CollettivoCocomeri/Felfil-Evo/README.md

# Felfil Evo
Evolved open source DIY 3D printer filament extruder

In this folder you will find all you need to replicate, modify and implement Felfil Evo

Contents of the folder:

- 3D-Model
- BOM
- Electronics
- FEBK - Basic Kit
- License

Last update: 18/07/2016
