CollettivoCocomeri/Felfil-Evo/Electronics/PCB - WIP/readme

This is the WIP of the brand new PCB of Felfil Evo.

It's not ready, now is going to be tested.

---
PCB Release Date: 09/06/2016
PCB Version: 0.9
---
