CollettivoCocomeri/Felfil-Evo/BOM/readme

In this folder you will find:

- Basic BOM (Bill of Materials) of Felfil Evo.

---
BOM Released Date: 17/11/2015
BOM Version: 1.0
---
