CollettivoCocomeri/Felfil-Evo/3D-Model/PrintableModel/HopperTop.stl

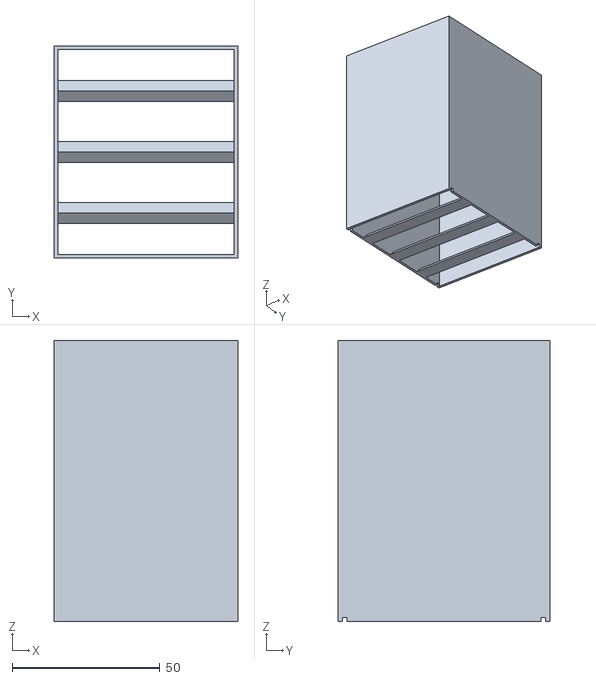
[picture p1: CAD file, 2017-03-28]
3D-Model/PrintableModel/HopperTop.stl
62.3 x 72.0 x 95.2
