CollettivoCocomeri/Felfil-Evo/3D-Model/PrintableModel/HopperBottom.stl

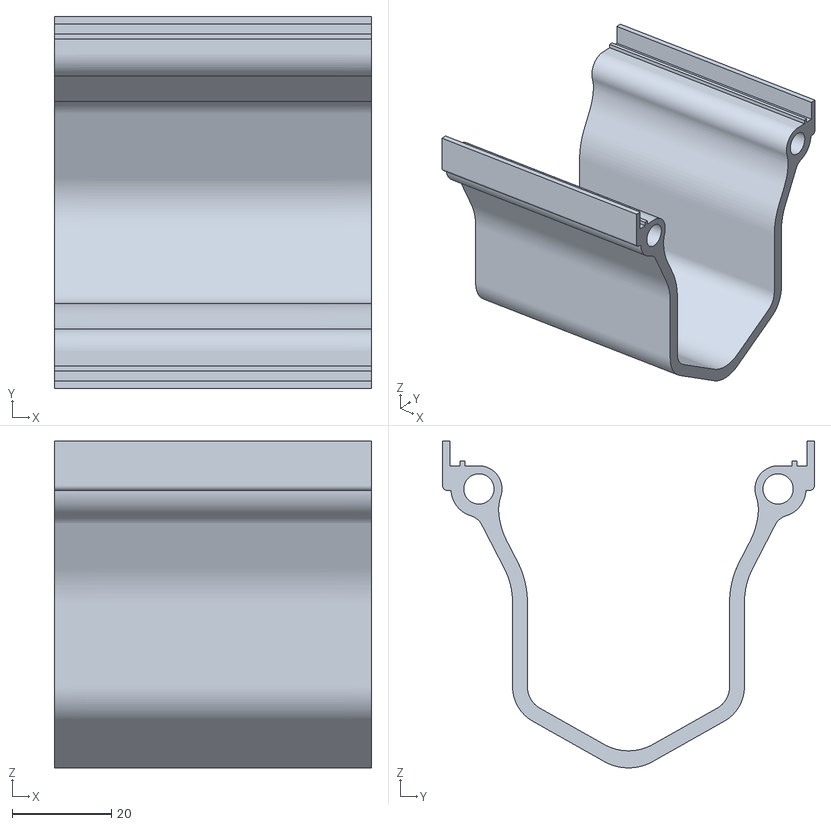
[picture p2: CAD file, 2017-03-28]
3D-Model/PrintableModel/HopperBottom.stl
64.0 x 75.1 x 65.9
