CollettivoCocomeri/Felfil-Evo/3D-Model/PrintableModel/readme

In this folder you can find:

- Top Hopper
- Bottom Hopper

of Felfil Evo.

The files are in .stl format, so you can easily import them in your favorite 3d Printer software.

We encourage you to download, test and enanche them!
