CollettivoCocomeri/Felfil-Evo/(threads)

Thread 4 (2019-01-06):

Thermistor variability

yeowjoon99, 2019-01-06:
My issue with the current felfil evo is to do with it's firmware.

Most people who are interested in the felfil evo are likely interested in 3D printing or own a 3D printer.

The issue I see is that in the firmware, I can't find any kind of temperature table that relates the thermistor's voltages with temperature values like in marlin firmware.
If this arduino board itself is capable of doing this conversion by itself or it's not blatantly shown in the firmware, someone please explain it to me.

Also, in the BOM, almost all parts aren't labelled with the exact type and model being used e.g. Arduino, fan, motor, LCD, encoder, thermistor.

The biggest issue with this lack of information is that I can't find a replacement in the event that that particular component might be damaged. Example would be a faulty thermistor. I wouldn't know which type to get if I don't know what type is used.

However if a temperature table is included in the firmware, it allows users to not only easily replace a faulty thermistor with one with a known temperature table, but it also allows users to upgrade it to a better one if they wish.

CollettivoCocomeri, 2019-01-07:
Hi,
thanks for contacting us, the reason of lacks of a temperature table is that
Felfil Evo does not use a thermistor but a K-type thermocouple.
About the Arduino, we mean a Uno board. The LCD is a i2C, and since it can
change often without advice form the seller, we include in code all the
working address we found. The click encoder module is quite standard.
However we will update the BOM, thaks.

Felfil s.r.l. | P.I. 11482100010
 <http://www.felfil.com/> www.felfil.com | C.so Castelfidardo 30/A, 10129
(TO)

Da: yeowjoon99 <notifications@github.com>
Inviato: domenica 6 gennaio 2019 16:50
A: CollettivoCocomeri/Felfil-Evo <Felfil-Evo@noreply.github.com>
Cc: Subscribed <subscribed@noreply.github.com>
Oggetto: [CollettivoCocomeri/Felfil-Evo] Thermistor variability (#4)

My issue with the current felfil evo is to do with it's firmware.

Most people who are interested in the felfil evo are likely interested in 3D
printing or own a 3D printer.

The issue I see is that in the firmware, I can't find any kind of
temperature table that relates the thermistor's voltages with temperature
values like in marlin firmware.
If this arduino board itself is capable of doing this conversion by itself
or it's not blatantly shown in the firmware, someone please explain it to
me.

Also, in the BOM, almost all parts aren't labelled with the exact type and
model being used e.g. Arduino, fan, motor, LCD, encoder, thermistor.

The biggest issue with this lack of information is that I can't find a
replacement in the event that that particular component might be damaged.
Example would be a faulty thermistor. I wouldn't know which type to get if I
don't know what type is used.

However if a temperature table is included in the firmware, it allows users
to not only easily replace a faulty thermistor with one with a known
temperature table, but it also allows users to upgrade it to a better one if
they wish.

-
You are receiving this because you are subscribed to this thread.
Reply to this email directly, view it on GitHub
<https://github.com/CollettivoCocomeri/Felfil-Evo/issues/4> , or mute the
thread
<https://github.com/notifications/unsubscribe-auth/AOizHdfkJLXkQ0gE0kgNOc7fZ
zvYrdnPks5vAhsUgaJpZM4Zyezb> .
<https://github.com/notifications/beacon/AOizHRxWdJRFGthNxYSVIswKCbr5SNI6ks5
vAhsUgaJpZM4Zyezb.gif>

<https://t.sidekickopen72.com/s1t/o/5/f18dQhb0S7kC8dDMPbW2n0x6l2B9gXrN7sKj6v
5KRN6W56jV1-1q0QkHW4WDX_q7qDc_gf197v5Y04?si=7000000001141521&pi=1855c4bb-ba5
e-42a2-a150-60d48d6bd497>

Closed 2021-09-22.

Thread 5 (2020-03-09):

BOM

Dario-Ciceri, 2020-03-09:
Ciao, a me piacerebbe ricreare questa macchina e magari aggiungere delle modifiche e fare un custom firmware. Non so però quali sono le componenti che usate per creare la macchina. Avreste dei nomi e delle part number? grazie

CollettivoCocomeri, 2020-03-09:
Ciao Dario,
puoi dirmi di quali parti avresti bisogno? Quasi tutta la meccanica è composta da componenti custom realizzati ad hoc di cui puoi trovare i file .step invece per quanto riguarda l’elettronica puoi clonare FelfilIno o realizzarla tramite Arduino e degli opportuni moduli

A presto
Alessandro

Felfil s.r.l. | P.I. 11482100010
 <http://www.felfil.com/> www.felfil.com | C.so Castelfidardo 30/A, 10129 (TO)

Da: Dario-Ciceri <notifications@github.com>
Inviato: lunedì 9 marzo 2020 13:57
A: CollettivoCocomeri/Felfil-Evo <Felfil-Evo@noreply.github.com>
Cc: Subscribed <subscribed@noreply.github.com>
Oggetto: [CollettivoCocomeri/Felfil-Evo] BOM (#5)

Ciao, a me piacerebbe ricreare questa macchina e magari aggiungere delle modifiche e fare un custom firmware. Non so però quali sono le componenti che usate per creare la macchina. Avreste dei nomi e delle part number? grazie

—
You are receiving this because you are subscribed to this thread.
Reply to this email directly, view it on GitHub <https://github.com/CollettivoCocomeri/Felfil-Evo/issues/5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> , or unsubscribe <https://github.com/notifications/unsubscribe-auth/ADULGHMFW6P7XEIHCI3LMVDRGTRSDANCNFSM4LEIDS2Q> .

Dario-Ciceri, 2020-03-09:
> Ciao Dario, puoi dirmi di quali parti avresti bisogno? Quasi tutta la meccanica è composta da componenti custom realizzati ad hoc di cui puoi trovare i file .step invece per quanto riguarda l’elettronica puoi clonare FelfilIno o realizzarla tramite Arduino e degli opportuni moduli A presto Alessandro Felfil s.r.l. | P.I. 11482100010 <http://www.felfil.com/> [www.felfil.com](http://www.felfil.com) | C.so Castelfidardo 30/A, 10129 (TO) Da: Dario-Ciceri <notifications@github.com> Inviato: lunedì 9 marzo 2020 13:57 A: CollettivoCocomeri/Felfil-Evo <Felfil-Evo@noreply.github.com> Cc: Subscribed <subscribed@noreply.github.com> Oggetto: [CollettivoCocomeri/Felfil-Evo] BOM (#5) Ciao, a me piacerebbe ricreare questa macchina e magari aggiungere delle modifiche e fare un custom firmware. Non so però quali sono le componenti che usate per creare la macchina. Avreste dei nomi e delle part number? grazie — You are receiving this because you are subscribed to this thread. Reply to this email directly, view it on GitHub <#5?email_source=notifications&email_token=ADULGHPCW732ITJDAR35GK3RGTRSDA5CNFSM4LEIDS22YY3PNVWWK3TUL52HS4DFUVEXG43VMWVGG33NNVSW45C7NFSM4ITR5NOQ> , or unsubscribe <https://github.com/notifications/unsubscribe-auth/ADULGHMFW6P7XEIHCI3LMVDRGTRSDANCNFSM4LEIDS2Q> .

Ciao, avrei bisogno di sapere il tipo di motore e gearboxes usate. Di file step ne vedo uno solo, è in scala 1:1?
grazie del supporto!

CollettivoCocomeri, 2020-03-09:
Sì il file step è in scala 1:1.
Ti allego qui la scheda tecnica del motore che utilizziamo noi.

Fammi sapere se hai bisogno d’altro.
Ciao
Alessandro

Felfil s.r.l. | P.I. 11482100010
 <http://www.felfil.com/> www.felfil.com | C.so Castelfidardo 30/A, 10129 (TO)

Da: Dario-Ciceri <notifications@github.com>
Inviato: lunedì 9 marzo 2020 16:13
A: CollettivoCocomeri/Felfil-Evo <Felfil-Evo@noreply.github.com>
Cc: Felfil <staff@felfil.com>; Comment <comment@noreply.github.com>
Oggetto: Re: [CollettivoCocomeri/Felfil-Evo] BOM (#5)

Ciao Dario, puoi dirmi di quali parti avresti bisogno? Quasi tutta la meccanica è composta da componenti custom realizzati ad hoc di cui puoi trovare i file .step invece per quanto riguarda l’elettronica puoi clonare FelfilIno o realizzarla tramite Arduino e degli opportuni moduli A presto Alessandro Felfil s.r.l. | P.I. 11482100010 http://www.felfil.com/ www.felfil.com <http://www.felfil.com>  | C.so Castelfidardo 30/A, 10129 (TO) Da: Dario-Ciceri notifications@github.com <mailto:notifications@github.com>  Inviato: lunedì 9 marzo 2020 13:57 A: CollettivoCocomeri/Felfil-Evo Felfil-Evo@noreply.github.com <mailto:Felfil-Evo@noreply.github.com>  Cc: Subscribed subscribed@noreply.github.com <mailto:subscribed@noreply.github.com>  Oggetto: [CollettivoCocomeri/Felfil-Evo] BOM (#5 <https://github.com/CollettivoCocomeri/Felfil-Evo/issues/5> ) Ciao, a me piacerebbe ricreare questa macchina e magari aggiungere delle modifiche e fare un custom firmware. Non so però quali sono le componenti che usate per creare la macchina. Avreste dei nomi e delle part number? grazie — You are receiving this because you are subscribed to this thread. Reply to this email directly, view it on GitHub < <https://github.com/CollettivoCocomeri/Felfil-Evo/issues/5> #5?email_source=notifications&email_token=ADULGHPCW732ITJDAR35GK3RGTRSDA5CNFSM4LEIDS22YY3PNVWWK3TUL52HS4DFUVEXG43VMWVGG33NNVSW45C7NFSM4ITR5NOQ> , or unsubscribe  <https://github.com/notifications/unsubscribe-auth/ADULGHMFW6P7XEIHCI3LMVDRGTRSDANCNFSM4LEIDS2Q> https://github.com/notifications/unsubscribe-auth/ADULGHMFW6P7XEIHCI3LMVDRGTRSDANCNFSM4LEIDS2Q .

Ciao, avrei bisogno di sapere il tipo di motore e gearboxes usate. Di file step ne vedo uno solo, è in scala 1:1?
grazie del supporto!

—
You are receiving this because you commented.
Reply to this email directly,  <https://github.com/CollettivoCocomeri/Felfil-Evo/issues/5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> view it on GitHub, or  <https://github.com/notifications/unsubscribe-auth/ADULGHIP5FZMZ6XAZEJ7XS3RGUBQXANCNFSM4LEIDS2Q> unsubscribe.

Dario-Ciceri, 2020-03-09:
> Sì il file step è in scala 1:1. Ti allego qui la scheda tecnica del motore che utilizziamo noi. Fammi sapere se hai bisogno d’altro. Ciao Alessandro Felfil s.r.l. | P.I. 11482100010 <http://www.felfil.com/> [www.felfil.com](http://www.felfil.com) | C.so Castelfidardo 30/A, 10129 (TO) Da: Dario-Ciceri <notifications@github.com> Inviato: lunedì 9 marzo 2020 16:13 A: CollettivoCocomeri/Felfil-Evo <Felfil-Evo@noreply.github.com> Cc: Felfil <staff@felfil.com>; Comment <comment@noreply.github.com> Oggetto: Re: [CollettivoCocomeri/Felfil-Evo] BOM (#5) Ciao Dario, puoi dirmi di quali parti avresti bisogno? Quasi tutta la meccanica è composta da componenti custom realizzati ad hoc di cui puoi trovare i file .step invece per quanto riguarda l’elettronica puoi clonare FelfilIno o realizzarla tramite Arduino e degli opportuni moduli A presto Alessandro Felfil s.r.l. | P.I. 11482100010 http://www.felfil.com/ [www.felfil.com](http://www.felfil.com) <http://www.felfil.com> | C.so Castelfidardo 30/A, 10129 (TO) Da: Dario-Ciceri notifications@github.com <mailto:notifications@github.com> Inviato: lunedì 9 marzo 2020 13:57 A: CollettivoCocomeri/Felfil-Evo Felfil-Evo@noreply.github.com <mailto:Felfil-Evo@noreply.github.com> Cc: Subscribed subscribed@noreply.github.com <mailto:subscribed@noreply.github.com> Oggetto: [CollettivoCocomeri/Felfil-Evo] BOM (#5 <#5> ) Ciao, a me piacerebbe ricreare questa macchina e magari aggiungere delle modifiche e fare un custom firmware. Non so però quali sono le componenti che usate per creare la macchina. Avreste dei nomi e delle part number? grazie — You are receiving this because you are subscribed to this thread. Reply to this email directly, view it on GitHub < <#5> #5?email_source=notifications&email_token=ADULGHPCW732ITJDAR35GK3RGTRSDA5CNFSM4LEIDS22YY3PNVWWK3TUL52HS4DFUVEXG43VMWVGG33NNVSW45C7NFSM4ITR5NOQ> , or unsubscribe <https://github.com/notifications/unsubscribe-auth/ADULGHMFW6P7XEIHCI3LMVDRGTRSDANCNFSM4LEIDS2Q> https://github.com/notifications/unsubscribe-auth/ADULGHMFW6P7XEIHCI3LMVDRGTRSDANCNFSM4LEIDS2Q . Ciao, avrei bisogno di sapere il tipo di motore e gearboxes usate. Di file step ne vedo uno solo, è in scala 1:1? grazie del supporto! — You are receiving this because you commented. Reply to this email directly, <#5?email_source=notifications&email_token=ADULGHISU66O57UDUAOUSJTRGUBQXA5CNFSM4LEIDS22YY3PNVWWK3TUL52HS4DFVREXG43VMVBW63LNMVXHJKTDN5WW2ZLOORPWSZGOEOHUHBI#issuecomment-596591493> view it on GitHub, or <https://github.com/notifications/unsubscribe-auth/ADULGHIP5FZMZ6XAZEJ7XS3RGUBQXANCNFSM4LEIDS2Q> unsubscribe.

ok grazie, aspetto che carichi la scheda tecnica! Se farò qualche modifica alla macchina la pubblicherò su una branch di questo progetto. A presto!!

CollettivoCocomeri, 2020-03-09:
Caricato!

Closed 2020-05-25.
