CollettivoCocomeri/Felfil-Evo/BOM/E1. Mellormotor.pdf

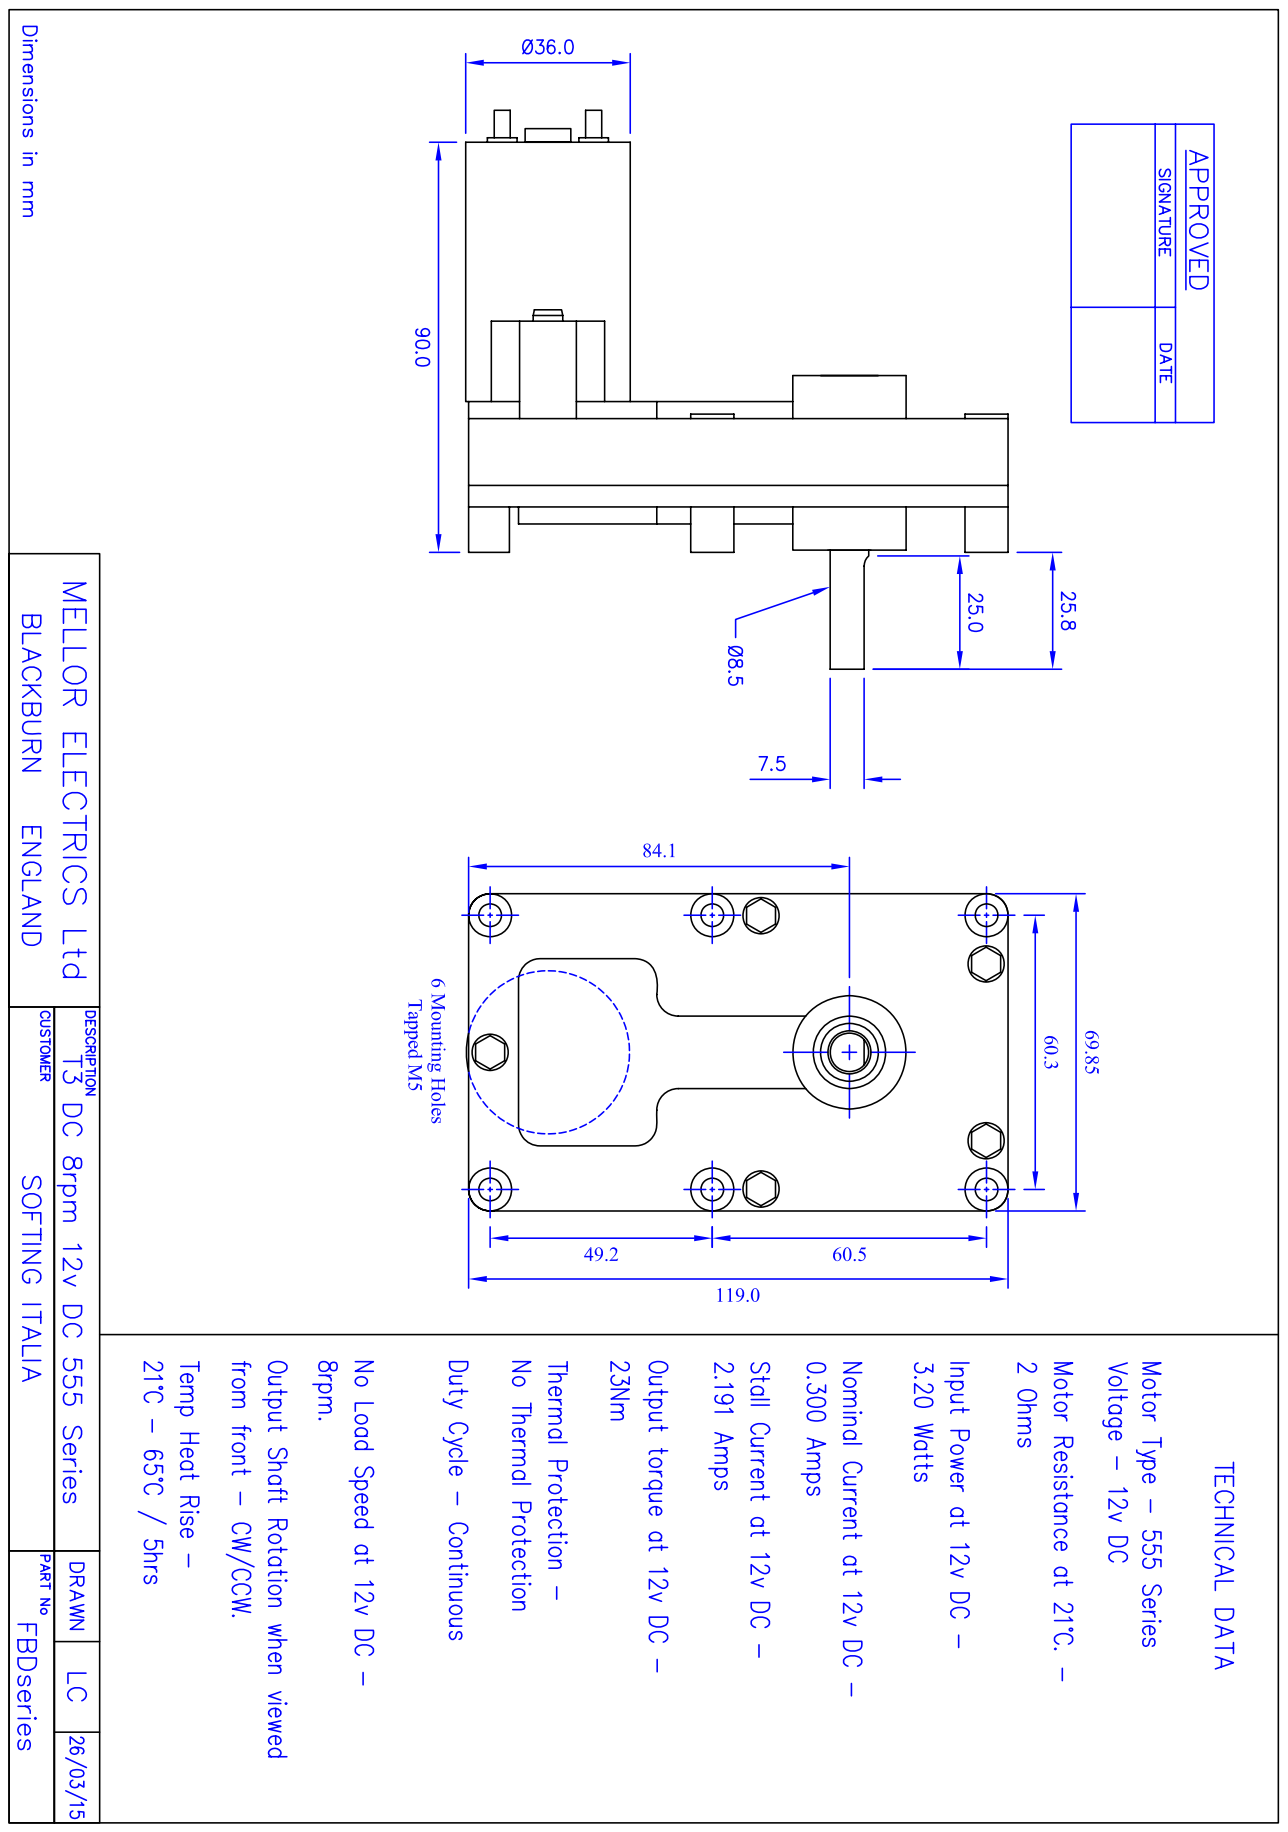
[picture p3: page 1]
