CollettivoCocomeri/Felfil-Evo/Electronics/PCB - WIP/Felfil_PCB_0.9.brd

## EAGLE design Electronics/PCB - WIP/Felfil_PCB_0.9.brd (2016-06-09)

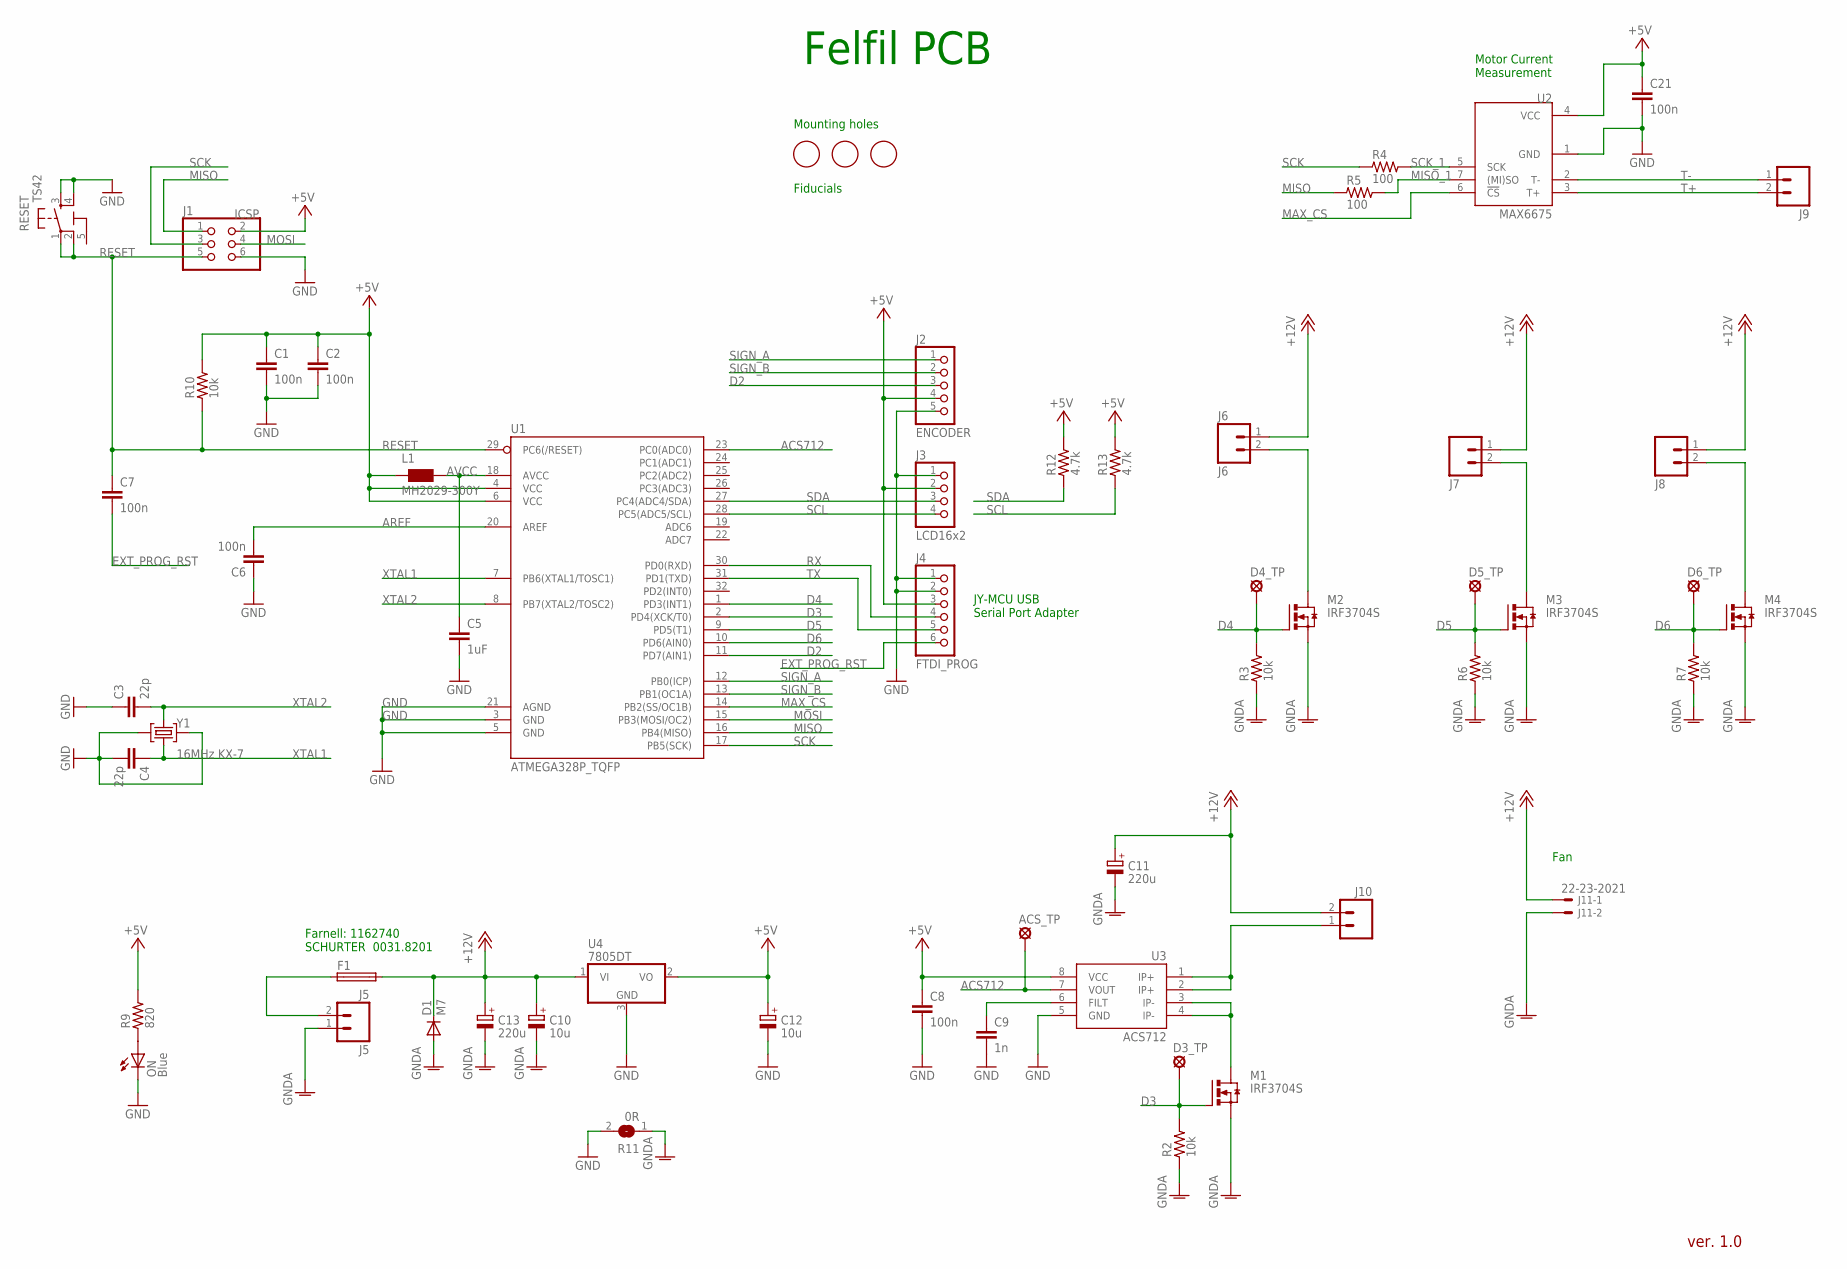
[picture p4: schematic Felfil_PCB_0.9.sch]

Parts:
ACS_TP: LSP11
C1, C2, C6, C7, C8, C21: 100n; C0603K
C3, C4: 22p; C0603K
C5: 1uF; C0603K
C9: 1n; C0603K
C10, C12: 10u; SMC_B
C11, C13: 220u; PANASONIC_F
D1: M7; SMB
D3_TP, D4_TP, D5_TP, D6_TP: LSP11
F1: FUSEBLANK_5X20MM; FUSE_HOLDER_5X20MM
FID1, FID2, FID3: FIDUCIALMOUNT; FIDUCIA-MOUNT
J1: ICSP; 2X03
J2: ENCODER; 1X05
J3: LCD16x2; 1X04
J4: FTDI_PROG; 1X06
J5: J5; SCREWTERMINAL-5MM-2
J6: J6; SCREWTERMINAL-5MM-2
J7, J8, J9, J10: M025MM; SCREWTERMINAL-5MM-2
J11: 22-23-2021
L1: MH2029-300Y; 0805
M1, M2, M3, M4: IRF3704S; D2PACK
ON: Blue; CHIPLED_0805
R2, R3, R6, R7, R10: 10k; R0603
R4, R5: 100; R0603
R9: 820; R0603
R11: 0R; SJW
R12, R13: 4.7k; R0603
RESET: TS42
U1: ATMEGA328P_TQFP; TQFP32-08
U2: MAX6675; SOIC8
U3: ACS712; SO08
U4: 7805DT; TO252
Y1: 16MHz KX-7; CRYSTAL-3.2-2.5

Connections:
5-GND: RESET.5 (5-GND)
+5V: C1.1, C2.1, C8.1, C12.+, C21.1, J1.2, J2.4, J3.2, J4.3, L1.1, R9.2, R10.2, R12.2, R13.2, U1.4 (VCC), U1.6 (VCC), U2.4 (VCC), U3.8 (VCC), U4.2 (VO)
+12V: C10.+, C11.+, C13.+, D1.C, F1.2, J6.1, J7.1, J8.1, J10.2, J11.1, U4.1 (VI)
ACS712: ACS_TP.MP, U1.23 (PC0(ADC0)), U3.7 (VOUT)
AREF: C6.2, U1.20 (AREF)
AVCC: C5.1, L1.2, U1.18 (AVCC)
D2: J2.3, U1.11 (PD7(AIN1))
D3: D3_TP.MP, M1.1 (G), R2.2, U1.2 (PD4(XCK/T0))
D4: D4_TP.MP, M2.1 (G), R3.2, U1.1 (PD3(INT1))
D5: D5_TP.MP, M3.1 (G), R6.2, U1.9 (PD5(T1))
D6: D6_TP.MP, M4.1 (G), R7.2, U1.10 (PD6(AIN0))
EXT_PROG_RST: C7.2, J4.6
GND: C1.2, C2.2, C3.1, C4.2, C5.2, C6.1, C8.2, C9.2, C12.-, C21.2, J1.6, J2.5, J3.1, J4.1, J4.2, ON.C, R11.2, RESET.3, RESET.4, U1.3 (GND), U1.5 (GND), U1.21 (AGND), U2.1 (GND), U3.5 (GND), U4.3 (GND), Y1.2 (GND), Y1.4 (GND)
GNDA: C10.-, C11.-, C13.-, D1.A, J5.1, J11.2, M1.3 (S), M2.3 (S), M3.3 (S), M4.3 (S), R2.1, R3.1, R6.1, R7.1, R11.1
MAX_CS: U1.14 (PB2(SS/OC1B)), U2.6 (!CS)
MISO: J1.1, R5.1, U1.16 (PB4(MISO))
MISO_1: R5.2, U2.7 ((MI)SO)
MOSI: J1.4, U1.15 (PB3(MOSI/OC2))
unnamed: C9.1, U3.6 (FILT)
unnamed: M1.2 (D), U3.3 (IP-), U3.4 (IP-)
unnamed: F1.1, J5.2
unnamed: ON.A, R9.1
unnamed: J10.1, U3.1 (IP+), U3.2 (IP+)
unnamed: J6.2, M2.2 (D)
unnamed: J7.2, M3.2 (D)
unnamed: J8.2, M4.2 (D)
RESET: C7.1, J1.5, R10.1, RESET.1, RESET.2, U1.29 (PC6(/RESET))
RX: J4.4, U1.30 (PD0(RXD))
SCK: J1.3, R4.1, U1.17 (PB5(SCK))
SCK_1: R4.2, U2.5 (SCK)
SCL: J3.4, R13.1, U1.28 (PC5(ADC5/SCL))
SDA: J3.3, R12.1, U1.27 (PC4(ADC4/SDA))
SIGN_A: J2.1, U1.12 (PB0(ICP))
SIGN_B: J2.2, U1.13 (PB1(OC1A))
T+: J9.2, U2.3 (T+)
T-: J9.1, U2.2 (T-)
TX: J4.5, U1.31 (PD1(TXD))
XTAL1: C4.1, U1.7 (PB6(XTAL1/TOSC1)), Y1.1 (C1)
XTAL2: C3.2, U1.8 (PB7(XTAL2/TOSC2)), Y1.3 (C2)

Notes on the sheet:
Felfil PCB
JY-MCU USB Serial Port Adapter
Mounting holes
Motor Current Measurement
Farnell: 1162740 SCHURTER 0031.8201
ver. 1.0
Fiducials
Fan

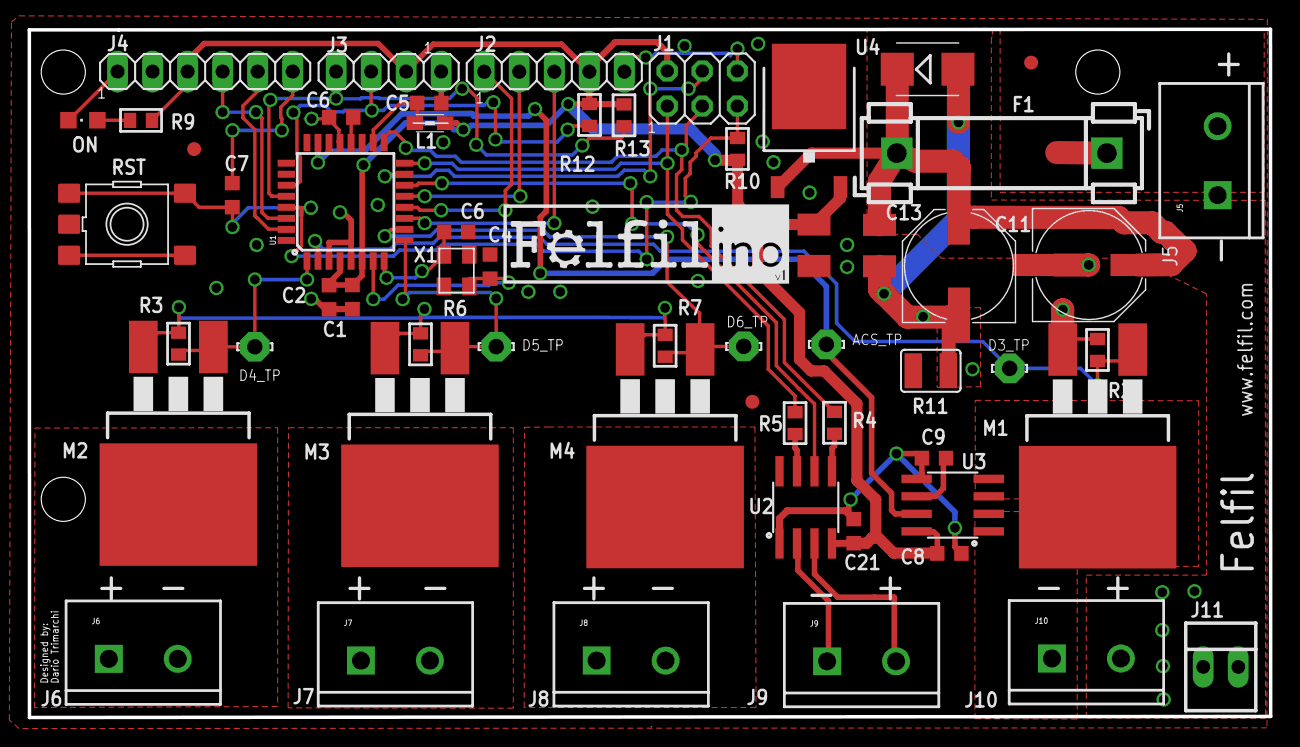
[picture p5: board Felfil_PCB_0.9.brd from above]

Board: 2 copper layers, 90.0 x 49.9 mm, 58 parts (0 on the bottom side), 38 nets.
