CollettivoCocomeri/Felfil-Evo/(commit log)

2015-10-26 Create bom
2015-10-26 Techs
    Techs
    [camera.dxf, case.dxf, isolante.dxf, pareti laterali.dxf, piattina.dxf, supporto serbatoio.dxf, ugello.dxf]
2015-10-26 Update bom
2015-11-17 Create BOM for makers with Felfil Evo Basic Kit
2015-11-20 Update BOM for makers with Felfil Evo Basic Kit
2016-03-23 Modulo temperatura + Conversione progetto a Visual Studio
2016-06-09 update 09/06/2016
    [Felfil_PCB_0.9.brd, Felfil_PCB_0.9.sch, camera.dxf, case.dxf, isolante.dxf, pareti laterali.dxf, piattina.dxf, supporto serbatoio.dxf]
2016-07-18 Added FEBK
    [Lasercut Vector.dxf]
2016-12-01 Revert "Modulo temperatura + Conversione progetto a Visual Studio"
    This reverts commit 7d116971531fbad943f1c42d7904d019b56a0802.
2017-01-18 update menu + lcd
    -attesa iniziale raggiungimento temperatura
    -settaggio iniziale pwm
    -modifica visualizzazione pwm
    -feedback heating
2017-03-28 Update 28032017
    Firmware V.0.9 - Felfil Evo Model1.2 - Printable hopper
    [HopperBottom.stl, HopperTop.stl]
2017-05-04 HowToUpdateFelfilEvoFirmware + Firmware ver 0.9.1
    Update guide, bug fix
    [FelfilController.cpp, FelfilMenu.h]
2021-09-22 Add files via upload
    o Seperation of functions definition from FelfilMenu.h
    o Little refactoring
    o Add of management for hardware malfunction
    "SENSOR_ERROR" // max6675 rotto -> temp = 750, termocoppia al contrario -> temp = 0
    "TERMAL_PROBE" // temperatura non sale quando scalda
    "PROBE_CONTACT" // c'è un intervallo troppo elevato tra un valore letto e il precedenze
    "PWM_PROTECTION" // protection mode (assirbimento motore > 2)
    "OVERHEATING" // scalda nonostante il raggiungimento del setpoint
    o Sostitution of LCD library
    o Minor bugs fixed
    [FelfilController.cpp, FelfilEvoFirmwareV1.3.ino, FelfilMenu.cpp, FelfilMenu.h]
2021-10-07 Add files via upload
    High temperatures heating bug correction
    [FelfilController.cpp, FelfilMenu.cpp, FelfilMenu.h]
2021-10-13 Add files via upload
    Change name errors
    [FelfilMenu.h]
