CollettivoCocomeri/Felfil-Evo/(notices)

Notices in the files:
parts and their libraries:
rc-master: Copyright (C) 2007, Bob Starr
SparkFun-DigitalIC: Licensing: Creative Commons ShareAlike 4.0 International - https://creativecommons.org/licenses/by-sa/4.0
